clovenbradshaw-ctrl/meshcore-phone/stl/cap/a15_cap.stl

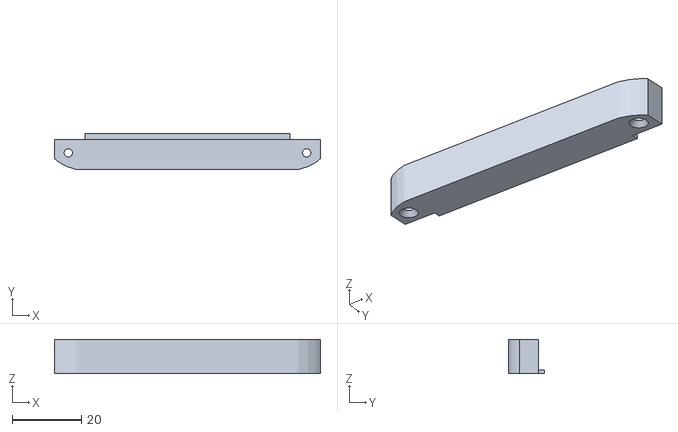
[picture p1: CAD file, 2026-10-25]
stl/cap/a15_cap.stl
76.9 x 10.4 x 9.90
