clovenbradshaw-ctrl/meshcore-phone/stl/no_solar/pixel10a_phone_body.stl

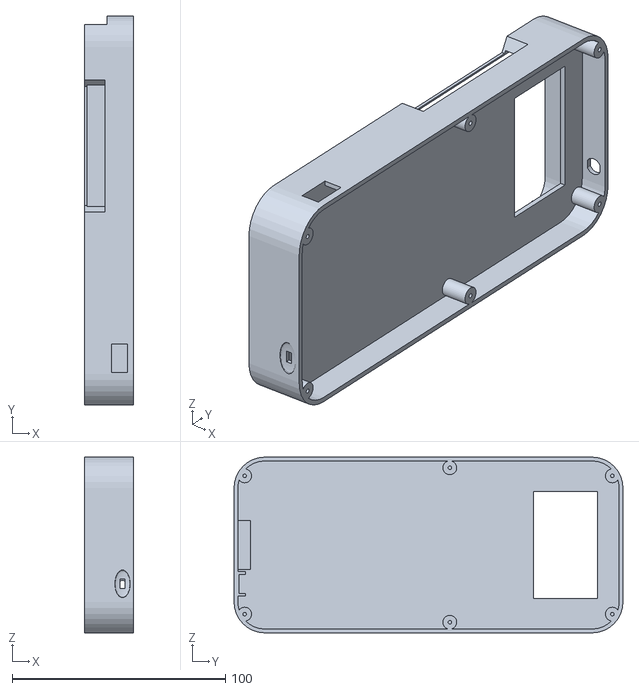
[picture p2: CAD file, 2026-10-26]
stl/no_solar/pixel10a_phone_body.stl
23.2 x 182.6 x 82.5
