clovenbradshaw-ctrl/meshcore-phone/stl/solar/pixel10a_solar_fit_test.stl

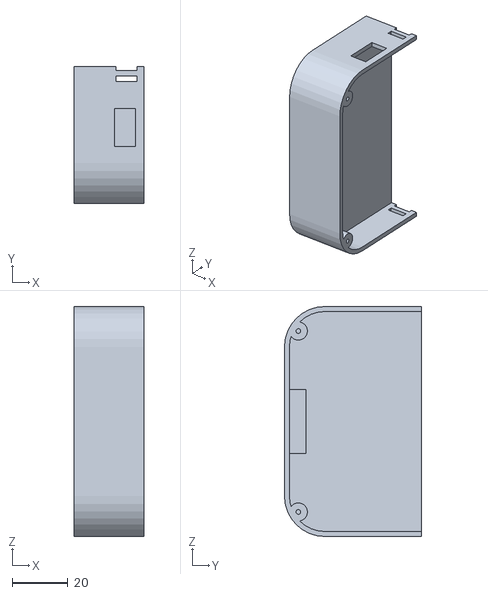
[picture p3: CAD file, 2026-10-26]
stl/solar/pixel10a_solar_fit_test.stl
25.2 x 49.2 x 82.5
