clovenbradshaw-ctrl/meshcore-phone/stl/cap/pixel8a_cap.stl

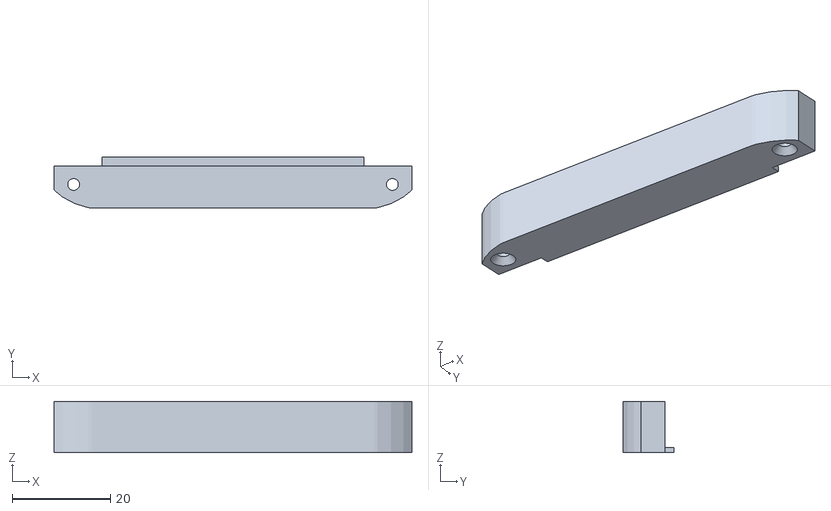
[picture p4: CAD file, 2026-10-25]
stl/cap/pixel8a_cap.stl
72.8 x 10.4 x 10.4
