clovenbradshaw-ctrl/meshcore-phone/stl/solar/pixel9a_solar_body.stl

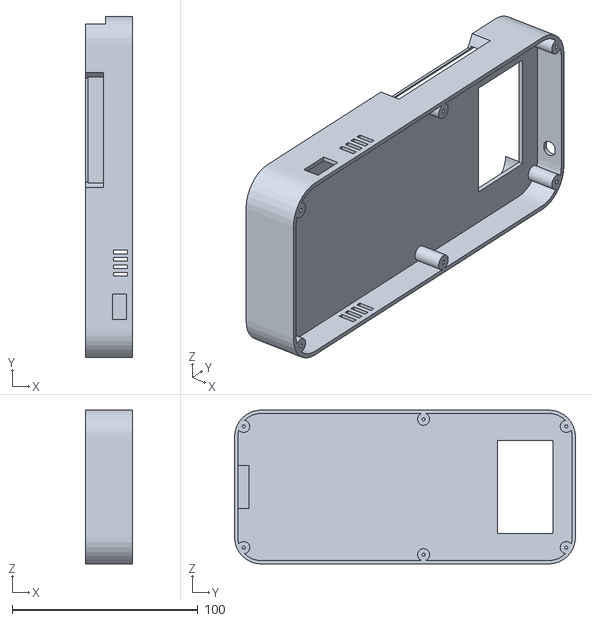
[picture p6: CAD file, 2026-10-26]
stl/solar/pixel9a_solar_body.stl
25.1 x 183.4 x 82.8
