clovenbradshaw-ctrl/meshcore-phone/stl/cap/pixel9_cap.stl

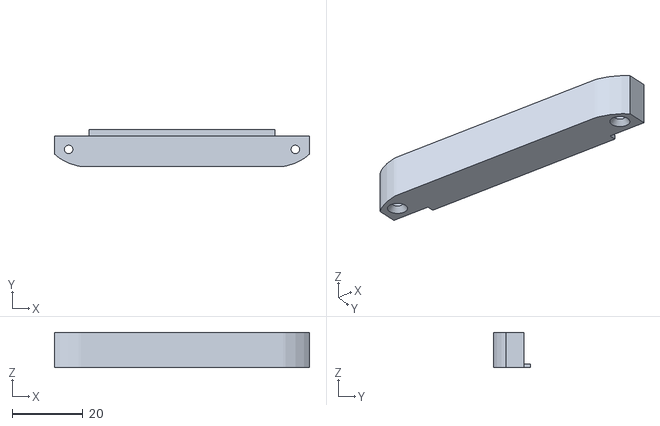
[picture p7: CAD file, 2026-10-25]
stl/cap/pixel9_cap.stl
72.1 x 10.4 x 10.00
