clovenbradshaw-ctrl/meshcore-phone/stl/no_solar/a15_phone_fit_test.stl

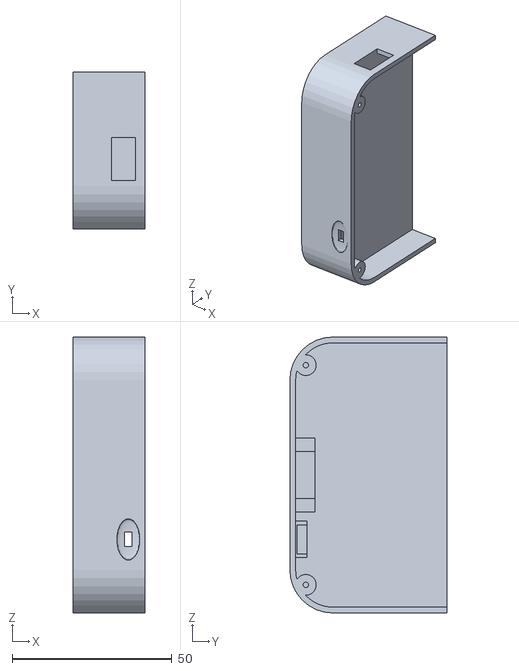
[picture p8: CAD file, 2026-10-26]
stl/no_solar/a15_phone_fit_test.stl
22.6 x 49.2 x 86.3
