clovenbradshaw-ctrl/meshcore-phone/stl/solar/gplay26_solar_fit_test.stl

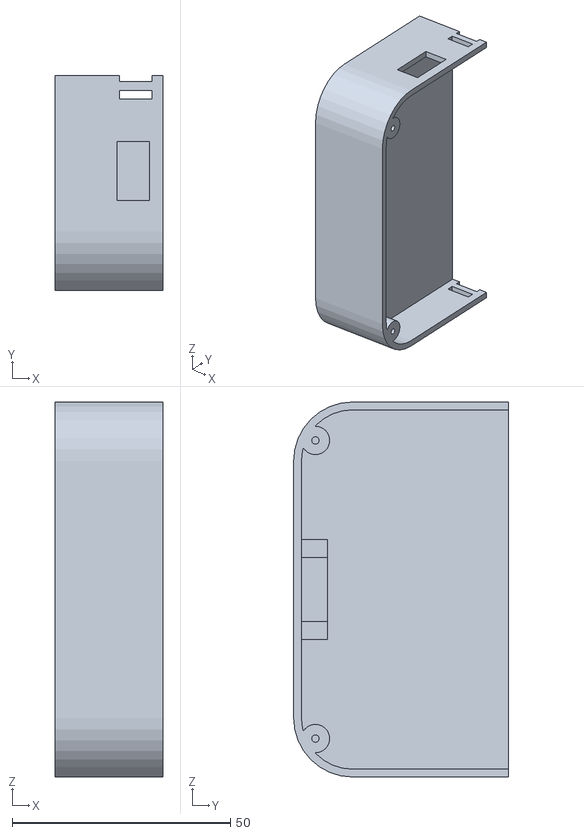
[picture p9: CAD file, 2026-10-26]
stl/solar/gplay26_solar_fit_test.stl
24.7 x 49.2 x 85.9
