clovenbradshaw-ctrl/meshcore-phone/stl/no_solar/pixel9a_phone_fit_test.stl

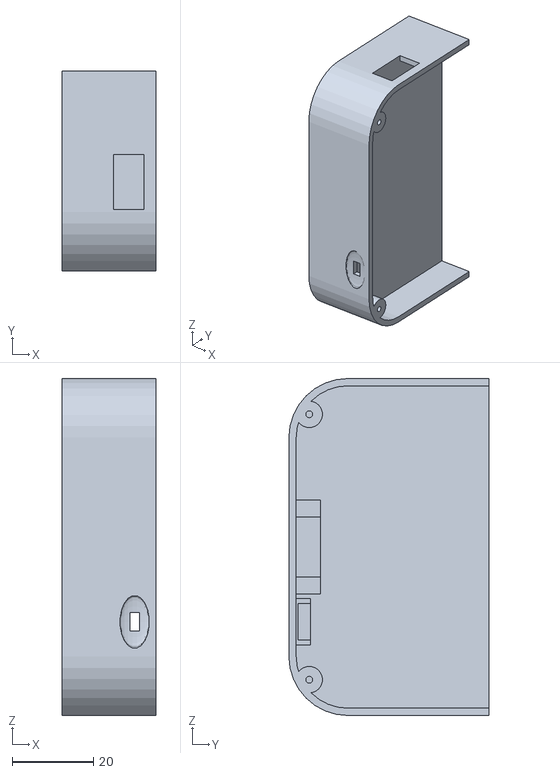
[picture p10: CAD file, 2026-10-26]
stl/no_solar/pixel9a_phone_fit_test.stl
23.1 x 49.2 x 82.8
