clovenbradshaw-ctrl/meshcore-phone/stl/solar/pixel10a_solar_body.stl

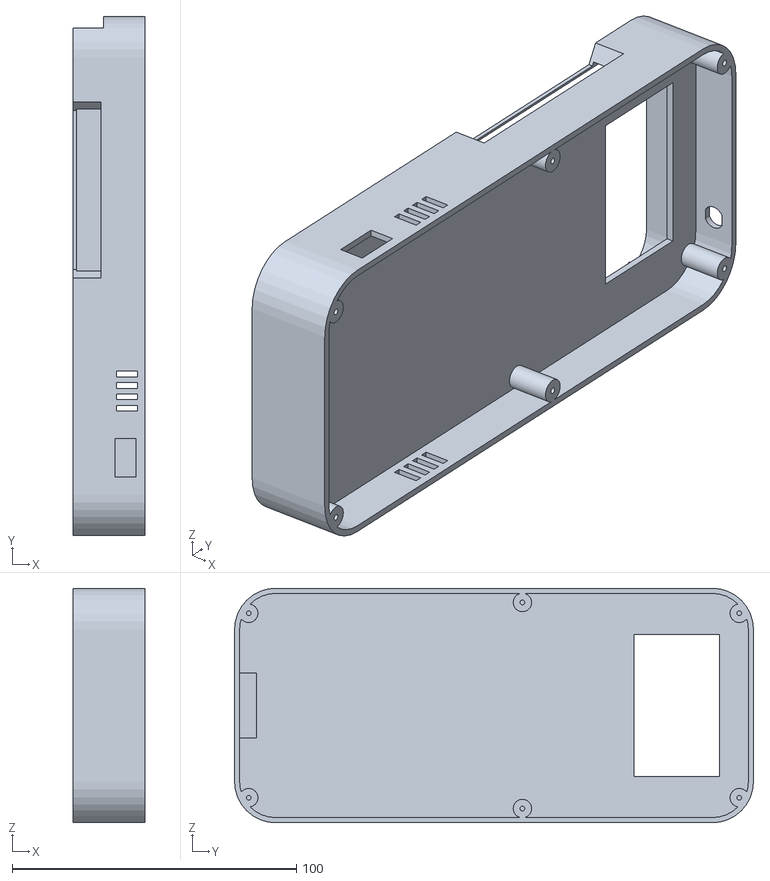
[picture p11: CAD file, 2026-10-26]
stl/solar/pixel10a_solar_body.stl
25.2 x 182.6 x 82.5
