clovenbradshaw-ctrl/meshcore-phone/stl/cap/g25_cap.stl

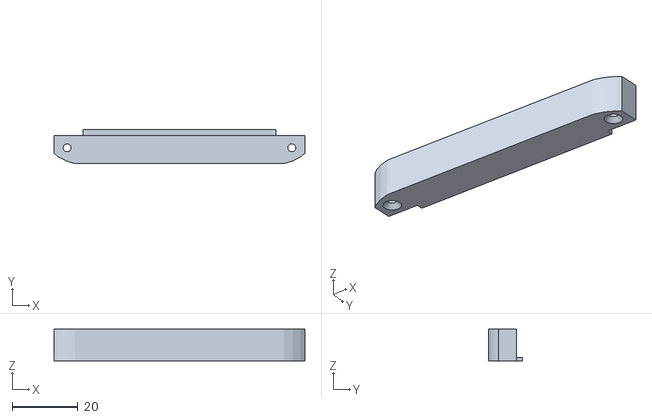
[picture p12: CAD file, 2026-10-25]
stl/cap/g25_cap.stl
76.4 x 10.4 x 9.70
