clovenbradshaw-ctrl/meshcore-phone/stl/no_solar/gplay26_phone_body.stl

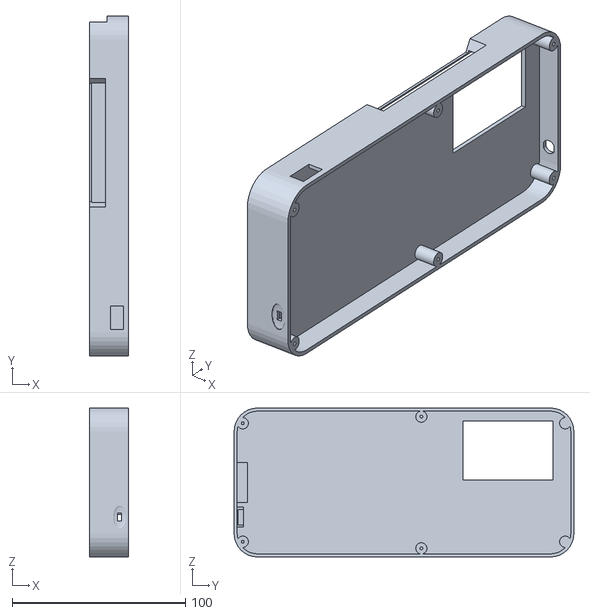
[picture p13: CAD file, 2026-10-26]
stl/no_solar/gplay26_phone_body.stl
22.7 x 195.9 x 85.9
