clovenbradshaw-ctrl/meshcore-phone/stl/solar/a16_solar_body.stl

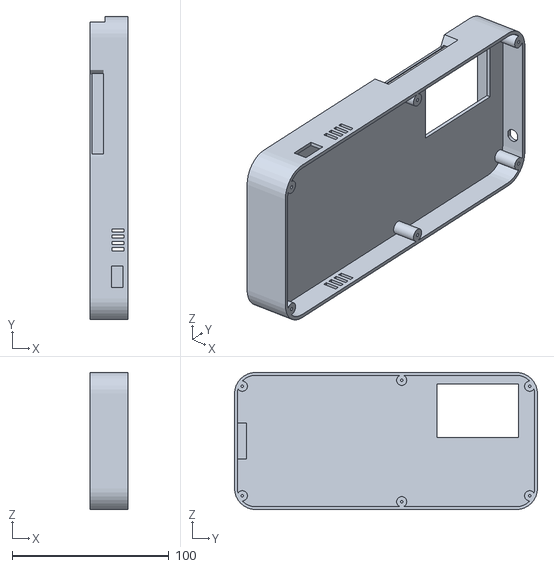
[picture p14: CAD file, 2026-10-26]
stl/solar/a16_solar_body.stl
24.1 x 193.1 x 87.4
