clovenbradshaw-ctrl/meshcore-phone/stl/no_solar/g25_phone_body.stl

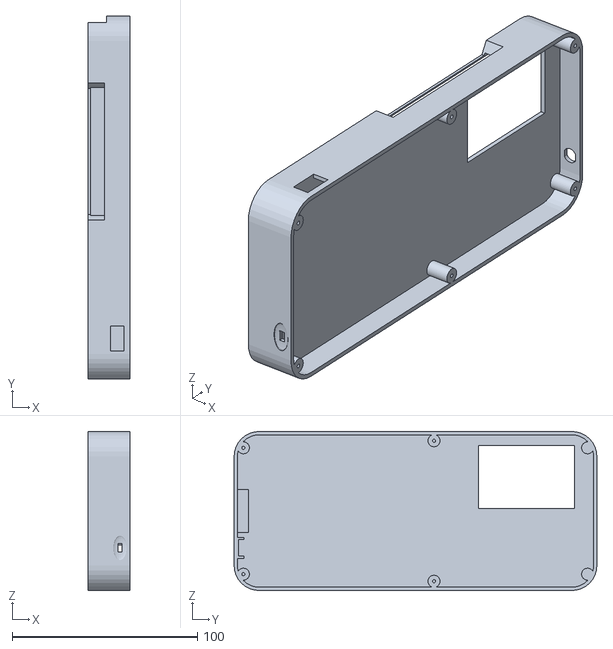
[picture p15: CAD file, 2026-10-26]
stl/no_solar/g25_phone_body.stl
22.4 x 195.8 x 85.8
