clovenbradshaw-ctrl/meshcore-phone/stl/cap/a16_cap.stl

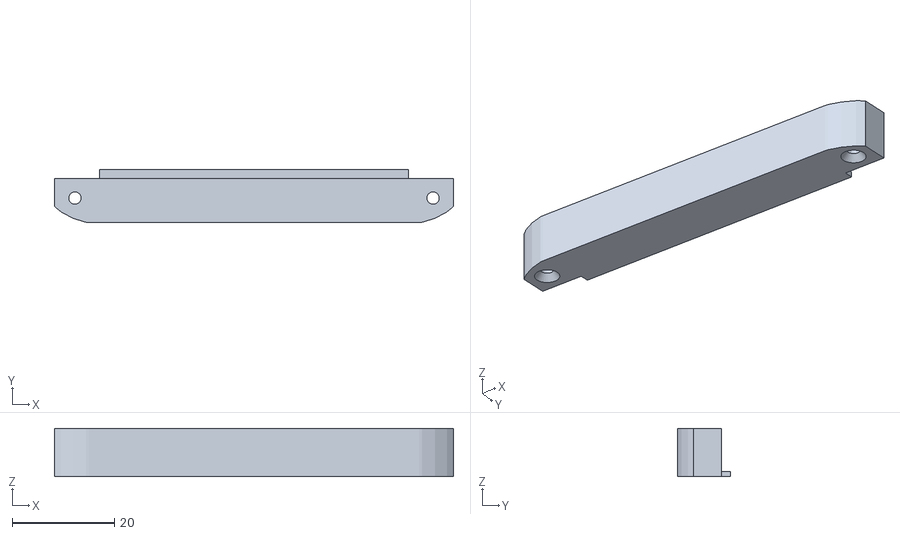
[picture p16: CAD file, 2026-10-25]
stl/cap/a16_cap.stl
78.0 x 10.4 x 9.40
