clovenbradshaw-ctrl/meshcore-phone/stl/solar/pixel9_solar_body.stl

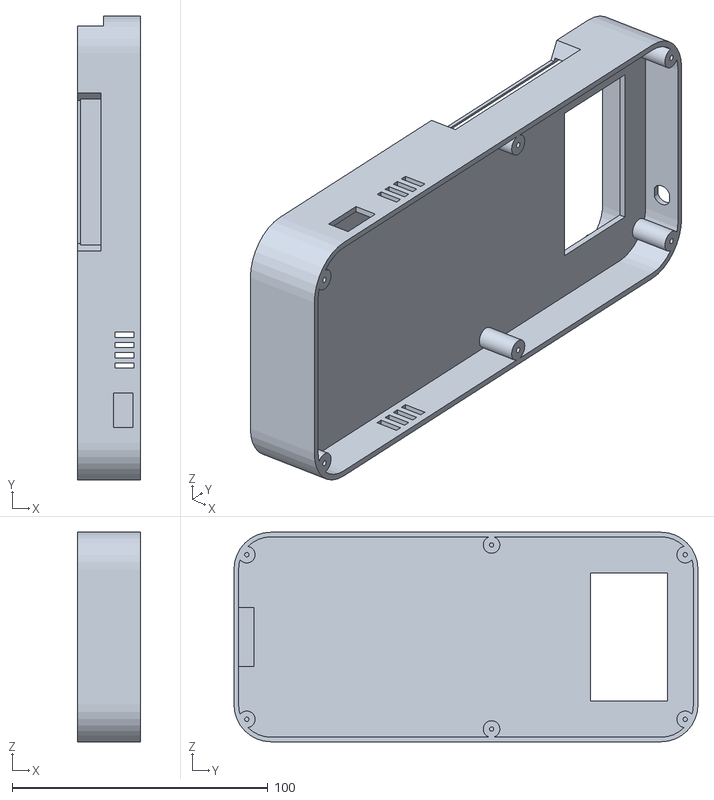
[picture p17: CAD file, 2026-10-26]
stl/solar/pixel9_solar_body.stl
24.7 x 181.5 x 82.0
