clovenbradshaw-ctrl/meshcore-phone/stl/no_solar/a16_phone_fit_test.stl

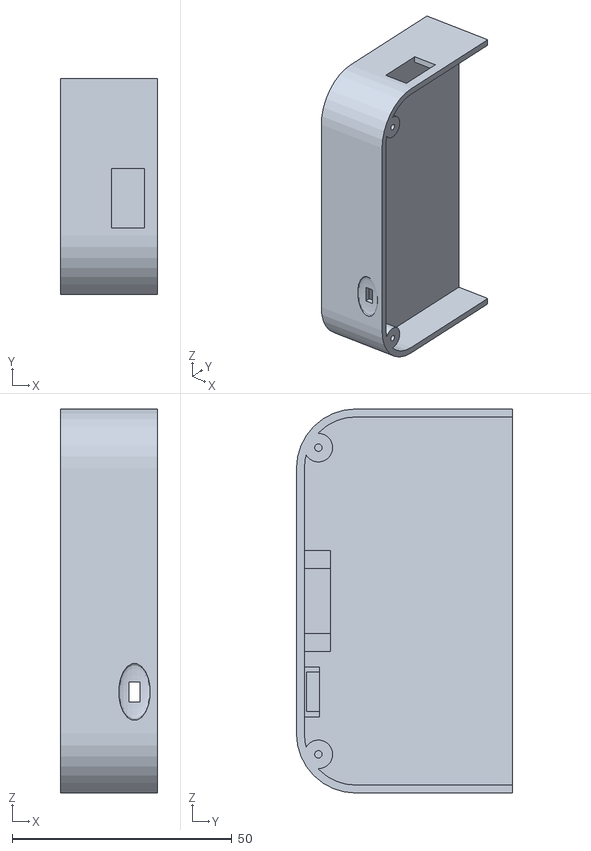
[picture p18: CAD file, 2026-10-26]
stl/no_solar/a16_phone_fit_test.stl
22.1 x 49.2 x 87.4
