clovenbradshaw-ctrl/meshcore-phone/stl/cap/gplay26_cap.stl

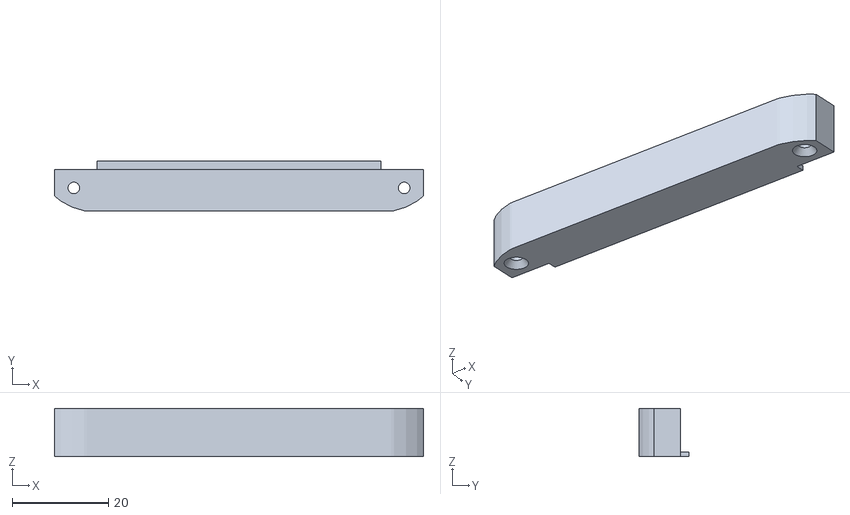
[picture p19: CAD file, 2026-10-25]
stl/cap/gplay26_cap.stl
76.5 x 10.4 x 10.00
