clovenbradshaw-ctrl/meshcore-phone/stl/no_solar/pixel9_phone_fit_test.stl

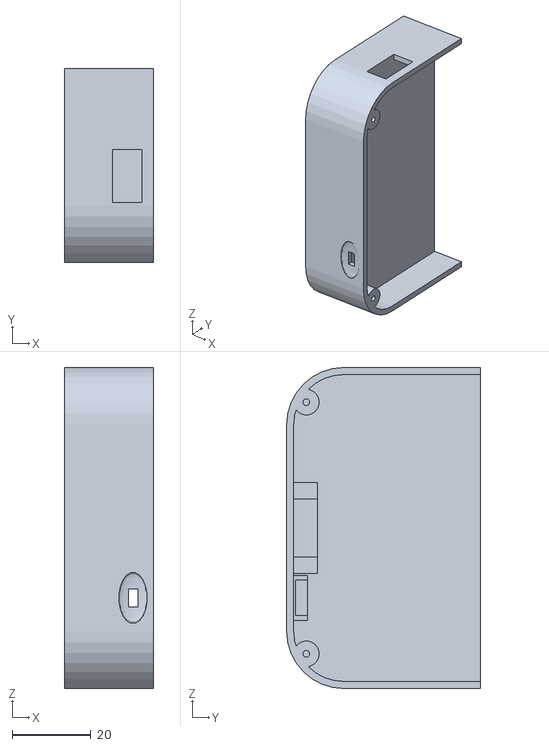
[picture p20: CAD file, 2026-10-26]
stl/no_solar/pixel9_phone_fit_test.stl
22.7 x 49.2 x 81.5
