clovenbradshaw-ctrl/meshcore-phone/stl/no_solar/pixel8a_phone_body.stl

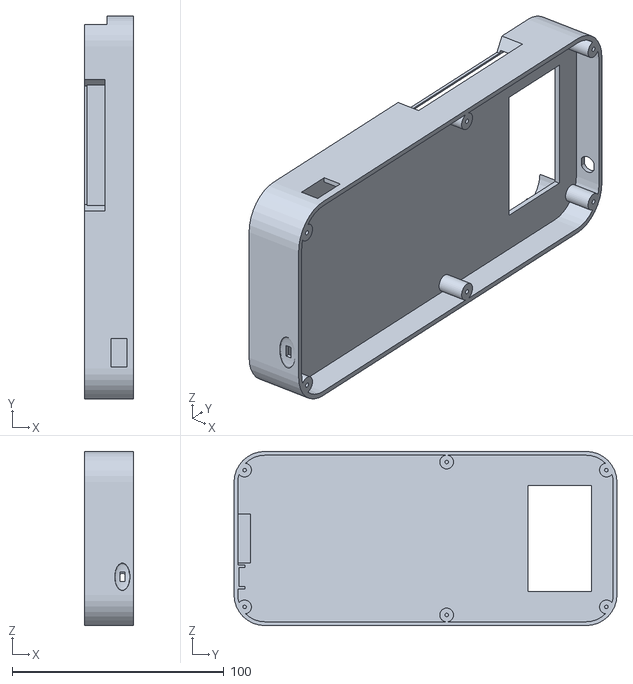
[picture p21: CAD file, 2026-10-26]
stl/no_solar/pixel8a_phone_body.stl
23.1 x 180.8 x 82.2
