clovenbradshaw-ctrl/meshcore-phone/stl/solar/g25_solar_fit_test.stl

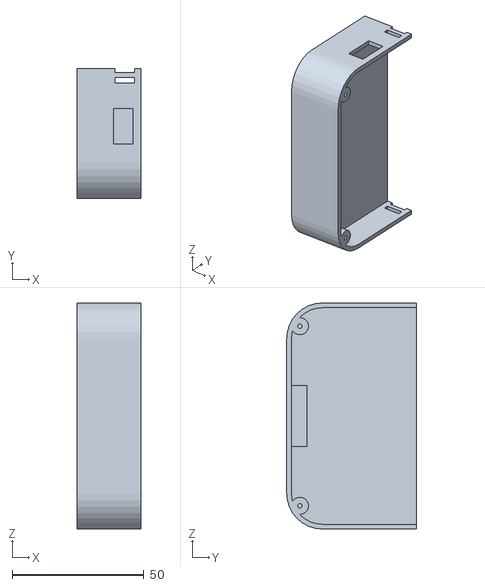
[picture p22: CAD file, 2026-10-26]
stl/solar/g25_solar_fit_test.stl
24.4 x 49.2 x 85.8
