clovenbradshaw-ctrl/meshcore-phone/stl/no_solar/a15_phone_body.stl

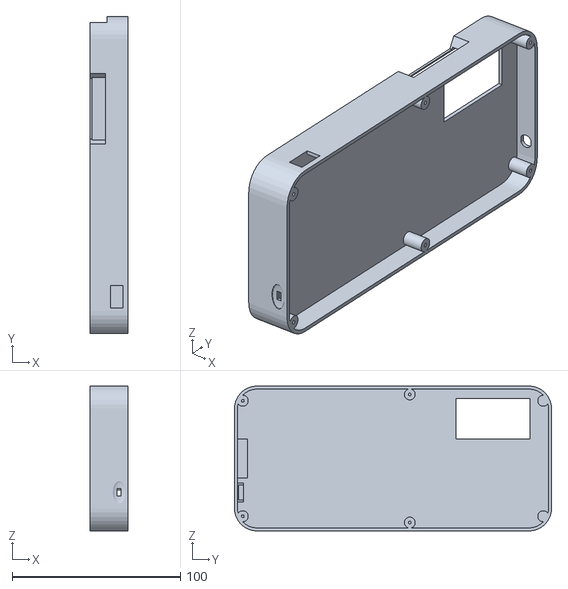
[picture p23: CAD file, 2026-10-26]
stl/no_solar/a15_phone_body.stl
22.6 x 188.8 x 86.3
