clovenbradshaw-ctrl/meshcore-phone/stl/solar/a16_solar_fit_test.stl

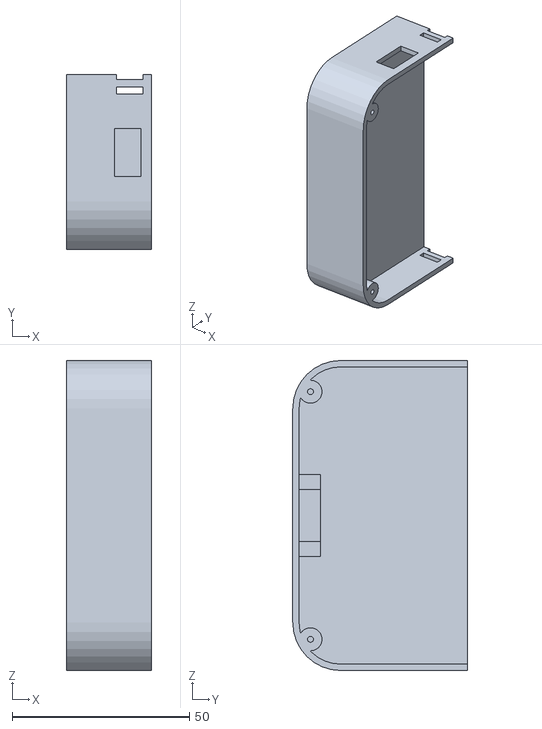
[picture p24: CAD file, 2026-10-26]
stl/solar/a16_solar_fit_test.stl
24.1 x 49.2 x 87.4
