clovenbradshaw-ctrl/meshcore-phone/stl/no_solar/pixel9a_phone_body.stl

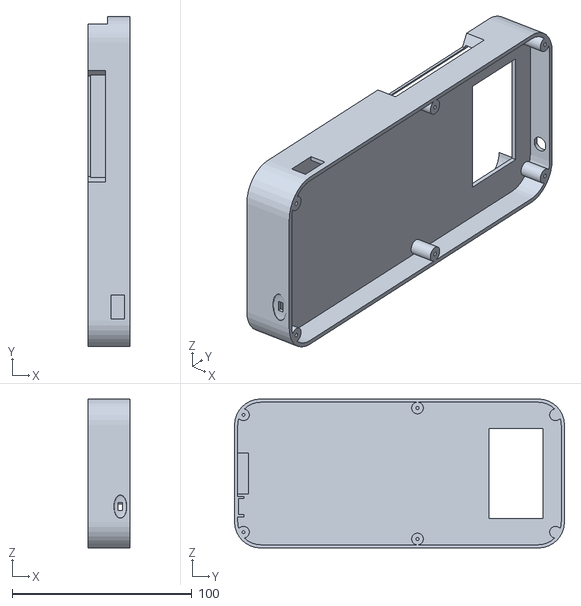
[picture p25: CAD file, 2026-10-26]
stl/no_solar/pixel9a_phone_body.stl
23.1 x 183.4 x 82.8
