clovenbradshaw-ctrl/meshcore-phone/stl/solar/pixel9a_solar_fit_test.stl

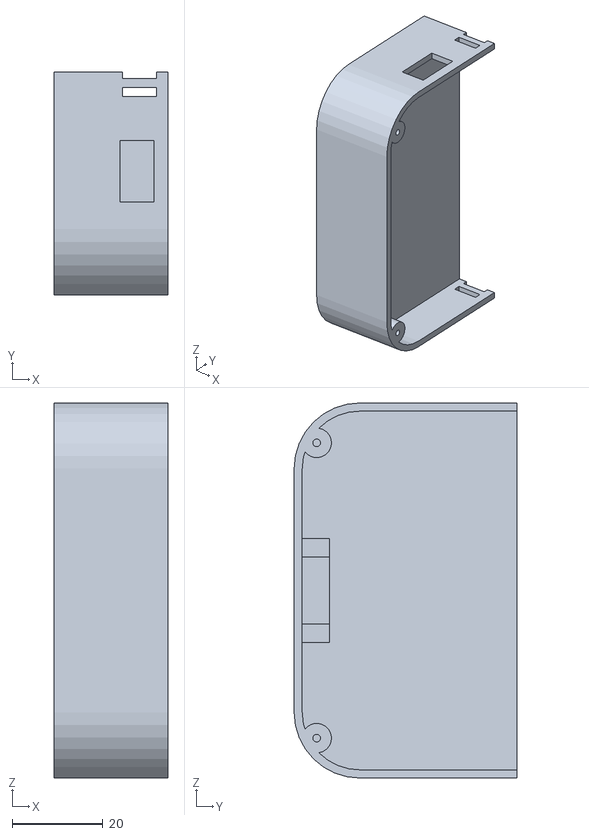
[picture p26: CAD file, 2026-10-26]
stl/solar/pixel9a_solar_fit_test.stl
25.1 x 49.2 x 82.8
