clovenbradshaw-ctrl/meshcore-phone/stl/no_solar/g25_phone_fit_test.stl

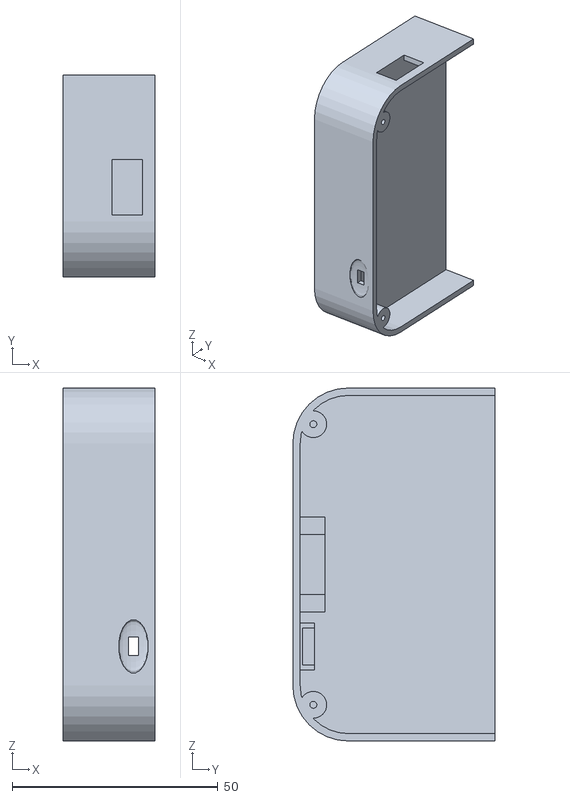
[picture p27: CAD file, 2026-10-26]
stl/no_solar/g25_phone_fit_test.stl
22.4 x 49.2 x 85.8
