clovenbradshaw-ctrl/meshcore-phone/stl/solar/g25_solar_body.stl

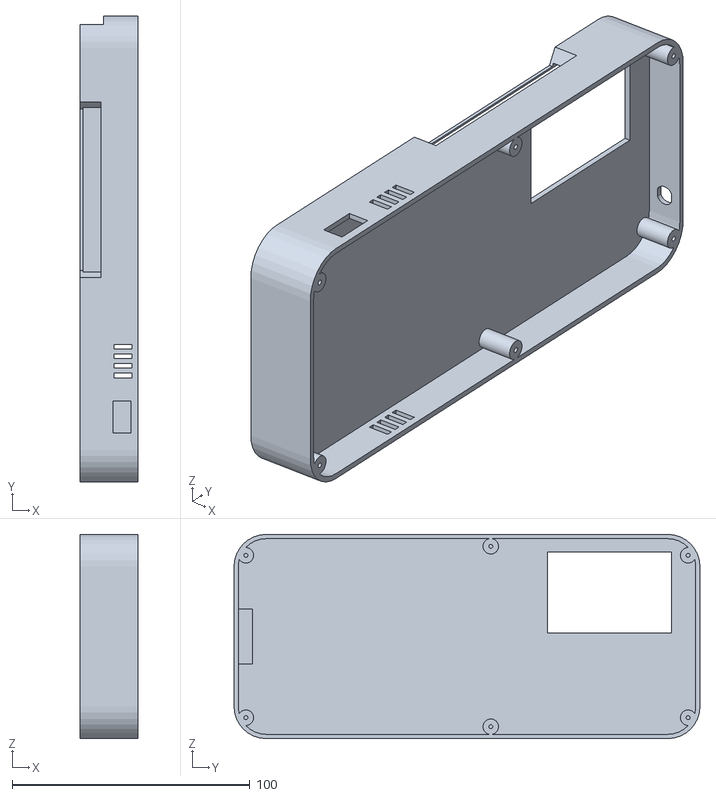
[picture p28: CAD file, 2026-10-26]
stl/solar/g25_solar_body.stl
24.4 x 195.8 x 85.8
