clovenbradshaw-ctrl/meshcore-phone/stl/no_solar/a16_phone_body.stl

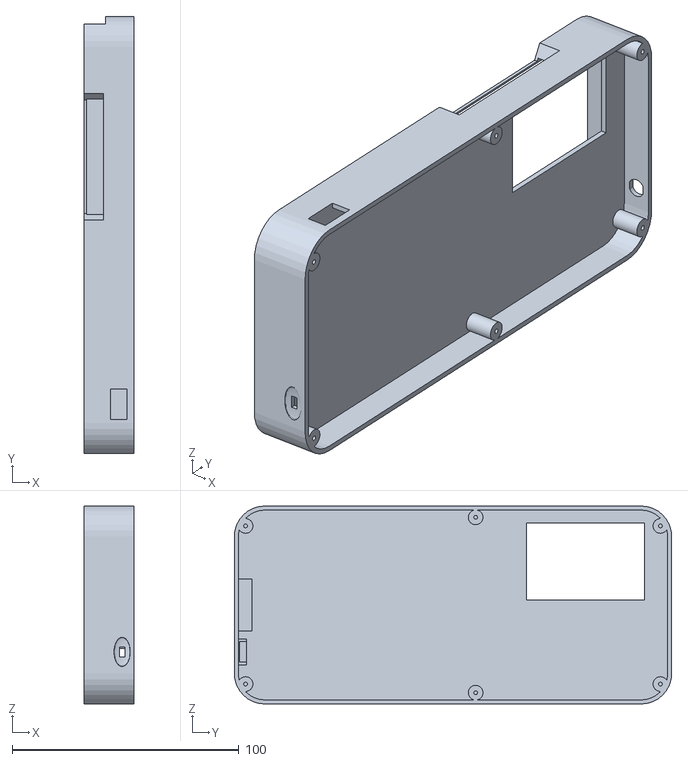
[picture p29: CAD file, 2026-10-26]
stl/no_solar/a16_phone_body.stl
22.1 x 193.1 x 87.4
