clovenbradshaw-ctrl/meshcore-phone/stl/solar/a15_solar_body.stl

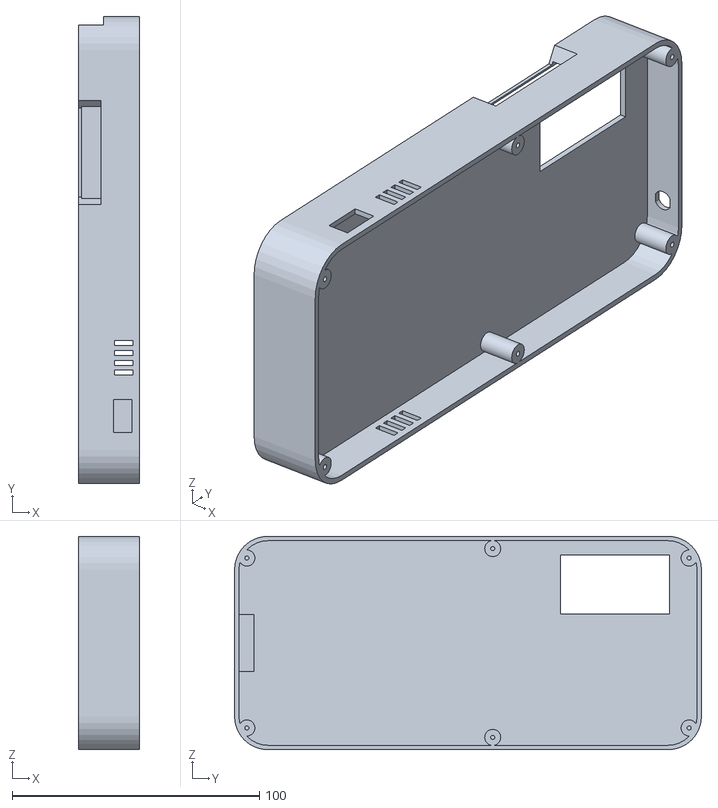
[picture p30: CAD file, 2026-10-26]
stl/solar/a15_solar_body.stl
24.6 x 188.8 x 86.3
