clovenbradshaw-ctrl/meshcore-phone/stl/solar/gplay26_solar_body.stl

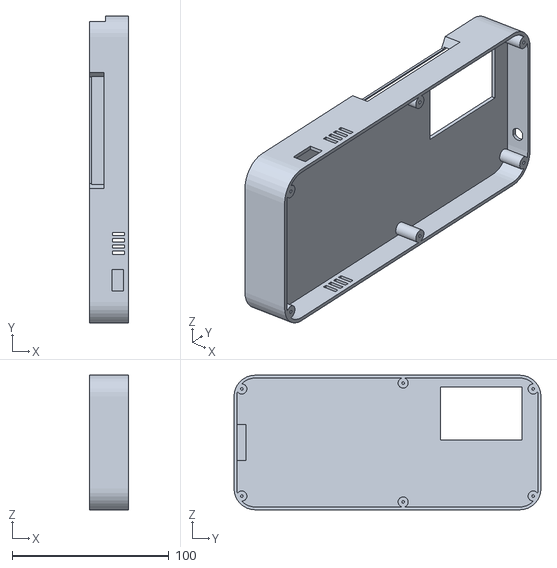
[picture p31: CAD file, 2026-10-26]
stl/solar/gplay26_solar_body.stl
24.7 x 195.9 x 85.9
