clovenbradshaw-ctrl/meshcore-phone/stl/no_solar/g25_phone_side_test.stl

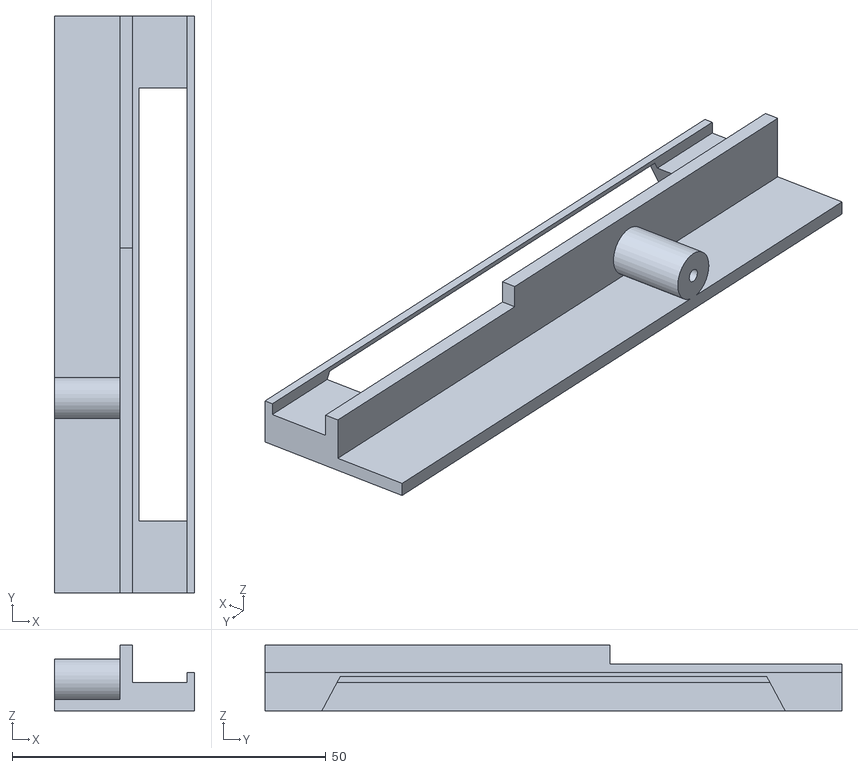
[picture p32: CAD file, 2026-10-25]
stl/no_solar/g25_phone_side_test.stl
22.4 x 92.0 x 10.5
