clovenbradshaw-ctrl/meshcore-phone/stl/solar/a16_solar_lid.stl

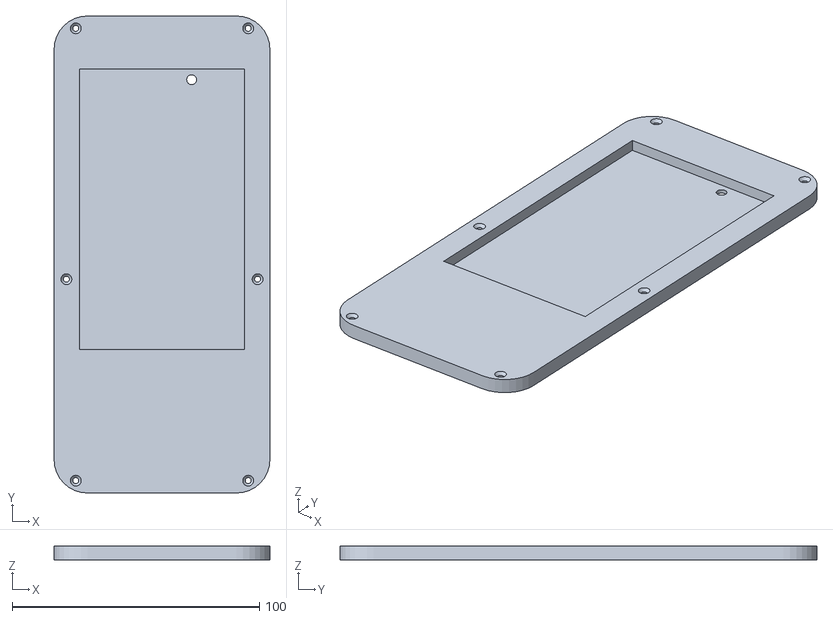
[picture p33: CAD file, 2026-10-25]
stl/solar/a16_solar_lid.stl
87.4 x 193.1 x 5.60
