clovenbradshaw-ctrl/meshcore-phone/stl/no_solar/a15_phone_lid.stl

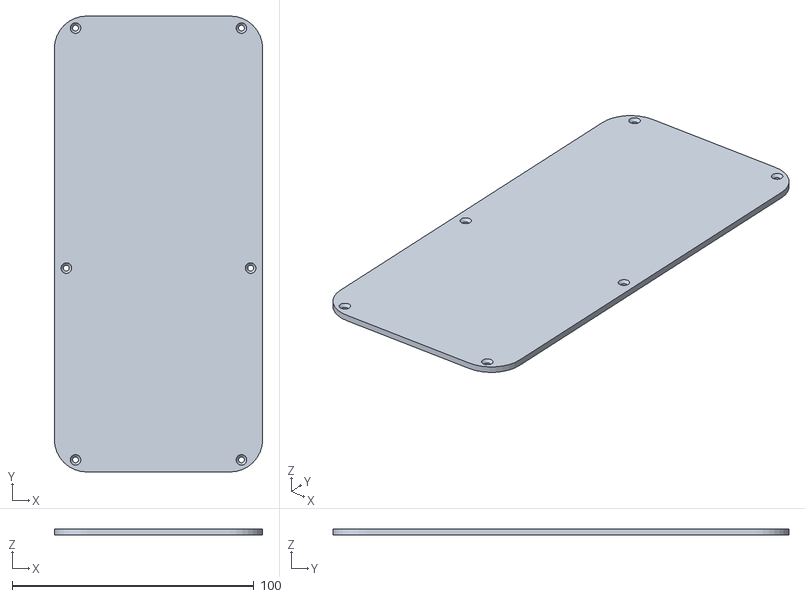
[picture p34: CAD file, 2026-10-25]
stl/no_solar/a15_phone_lid.stl
86.3 x 188.8 x 2.40
