clovenbradshaw-ctrl/meshcore-phone/stl/solar/pixel10a_solar_side_test.stl

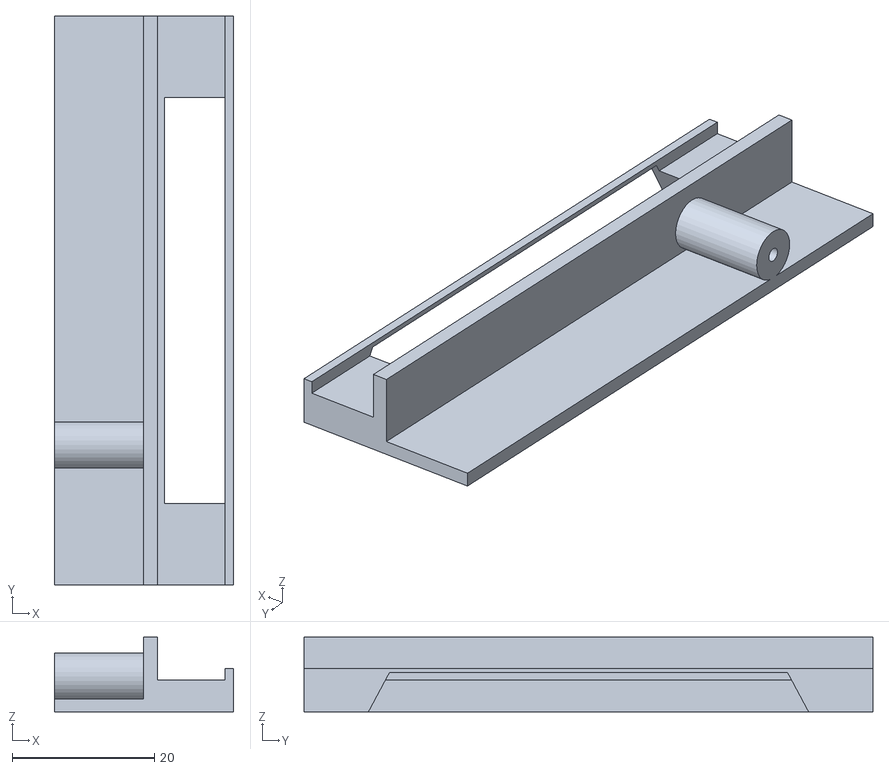
[picture p35: CAD file, 2026-10-25]
stl/solar/pixel10a_solar_side_test.stl
25.2 x 80.0 x 10.5
