clovenbradshaw-ctrl/meshcore-phone/stl/no_solar/pixel10_phone_lid.stl

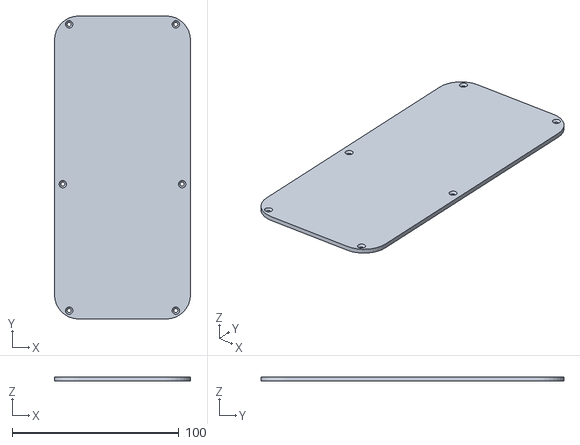
[picture p36: CAD file, 2026-10-25]
stl/no_solar/pixel10_phone_lid.stl
81.5 x 181.5 x 2.40
