clovenbradshaw-ctrl/meshcore-phone/stl/solar/gplay26_solar_lid.stl

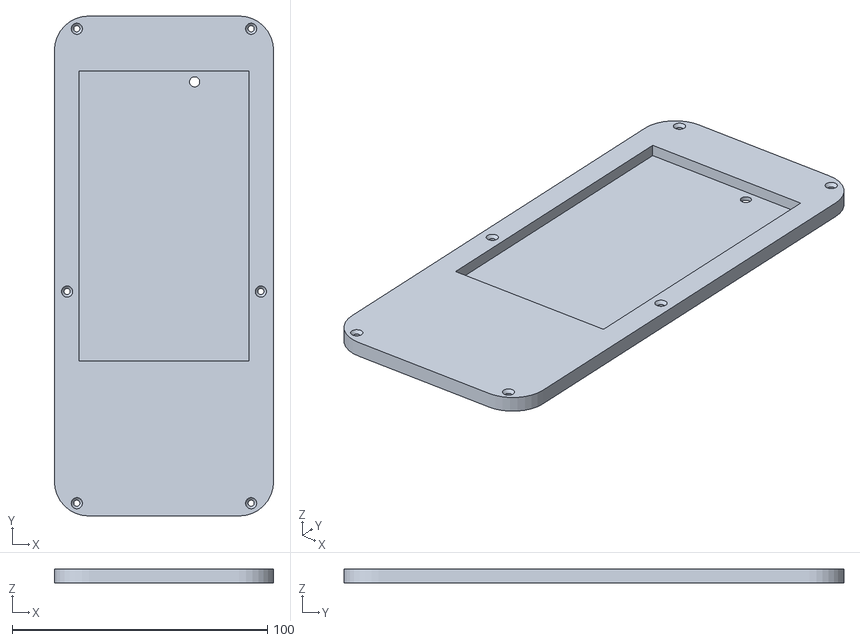
[picture p37: CAD file, 2026-10-25]
stl/solar/gplay26_solar_lid.stl
85.9 x 195.9 x 5.60
