clovenbradshaw-ctrl/meshcore-phone/stl/no_solar/a16_phone_lid.stl

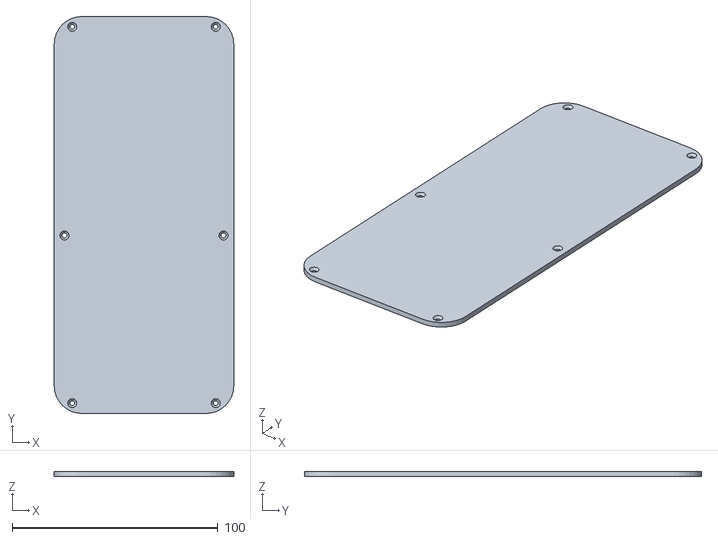
[picture p38: CAD file, 2026-10-25]
stl/no_solar/a16_phone_lid.stl
87.4 x 193.1 x 2.40
