clovenbradshaw-ctrl/meshcore-phone/stl/solar/pixel10_solar_lid.stl

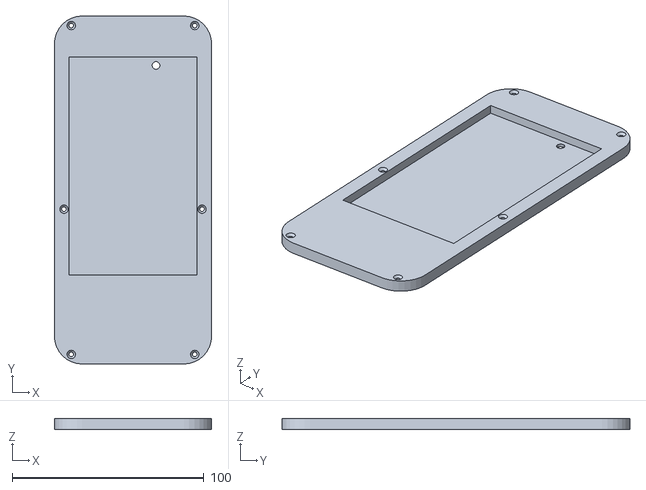
[picture p39: CAD file, 2026-10-25]
stl/solar/pixel10_solar_lid.stl
82.0 x 181.5 x 5.60
