clovenbradshaw-ctrl/meshcore-phone/stl/no_solar/pixel9_phone_side_test.stl

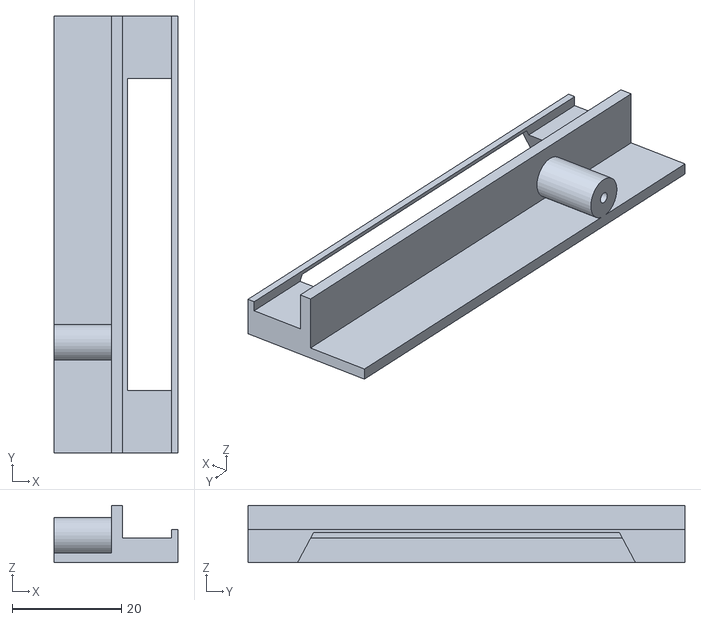
[picture p40: CAD file, 2026-10-25]
stl/no_solar/pixel9_phone_side_test.stl
22.7 x 80.0 x 10.5
