clovenbradshaw-ctrl/meshcore-phone/stl/no_solar/gplay26_phone_lid.stl

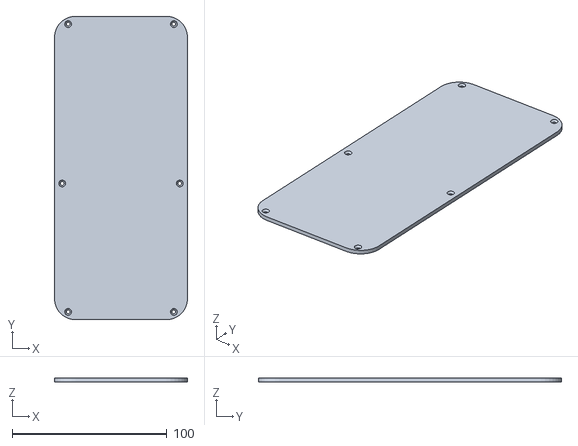
[picture p41: CAD file, 2026-10-25]
stl/no_solar/gplay26_phone_lid.stl
85.9 x 195.9 x 2.40
