clovenbradshaw-ctrl/meshcore-phone/stl/solar/a15_solar_lid.stl

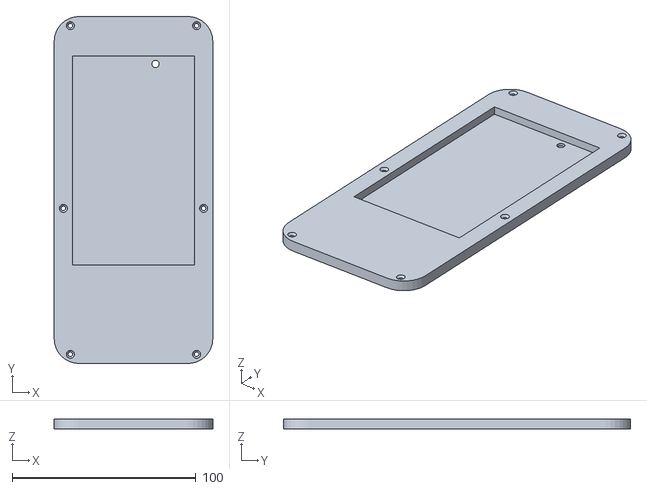
[picture p42: CAD file, 2026-10-25]
stl/solar/a15_solar_lid.stl
86.3 x 188.8 x 5.60
