clovenbradshaw-ctrl/meshcore-phone/stl/solar/gplay26_solar_side_test.stl

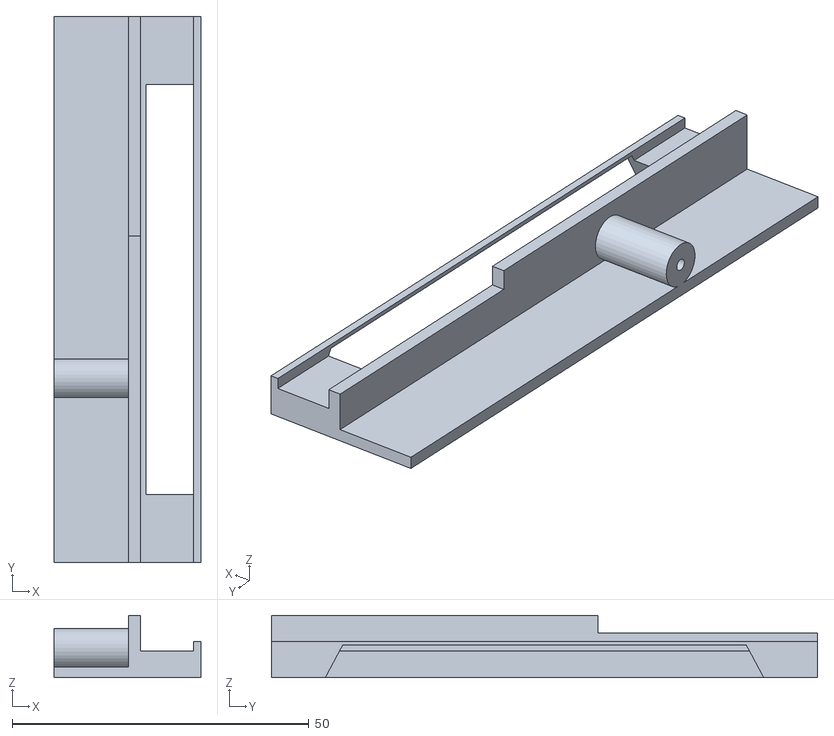
[picture p43: CAD file, 2026-10-25]
stl/solar/gplay26_solar_side_test.stl
24.7 x 92.0 x 10.5
