clovenbradshaw-ctrl/meshcore-phone/stl/no_solar/gplay26_phone_side_test.stl

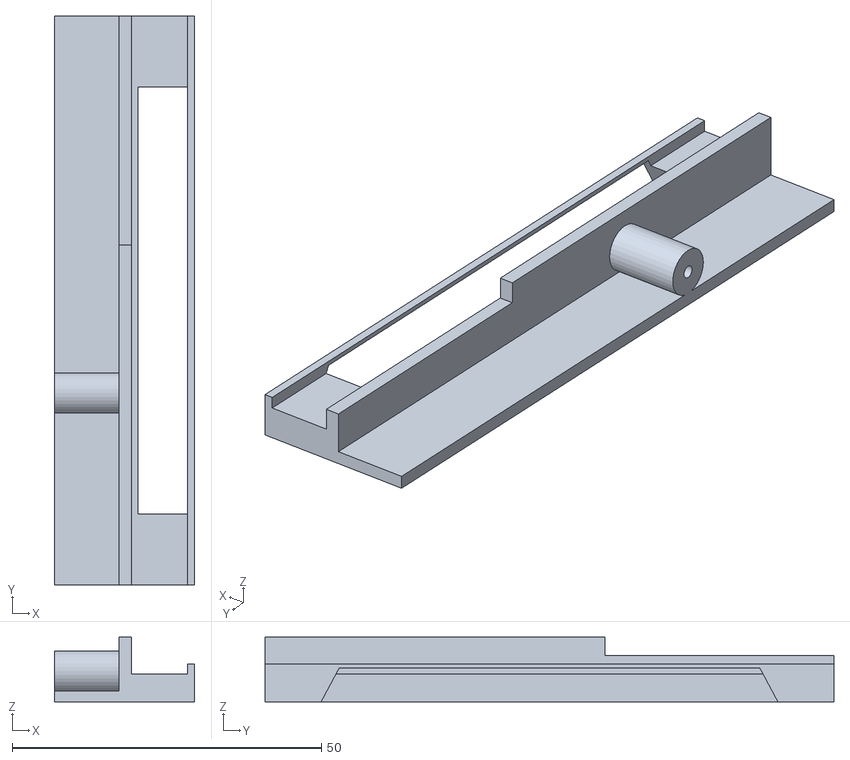
[picture p44: CAD file, 2026-10-25]
stl/no_solar/gplay26_phone_side_test.stl
22.7 x 92.0 x 10.5
