clovenbradshaw-ctrl/meshcore-phone/stl/solar/a16_solar_side_test.stl

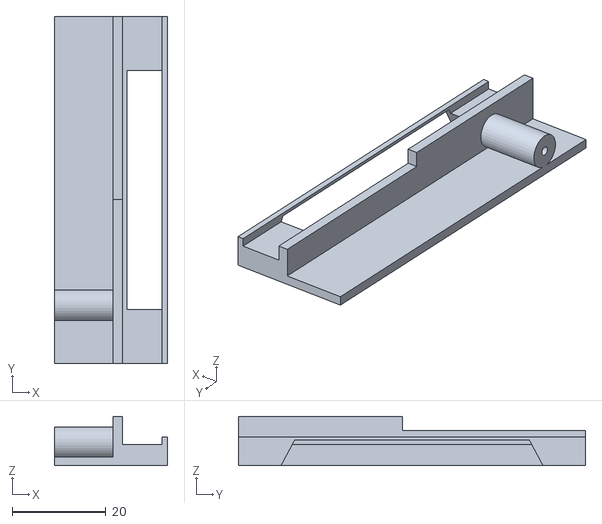
[picture p45: CAD file, 2026-10-25]
stl/solar/a16_solar_side_test.stl
24.1 x 74.0 x 10.5
