clovenbradshaw-ctrl/meshcore-phone/stl/no_solar/a16_phone_side_test.stl

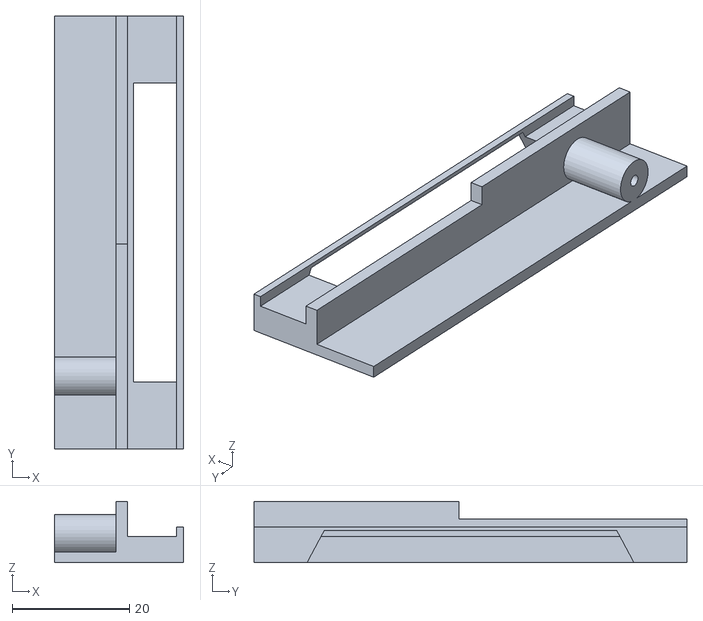
[picture p46: CAD file, 2026-10-25]
stl/no_solar/a16_phone_side_test.stl
22.1 x 74.0 x 10.5
