clovenbradshaw-ctrl/meshcore-phone/stl/no_solar/a15_phone_side_test.stl

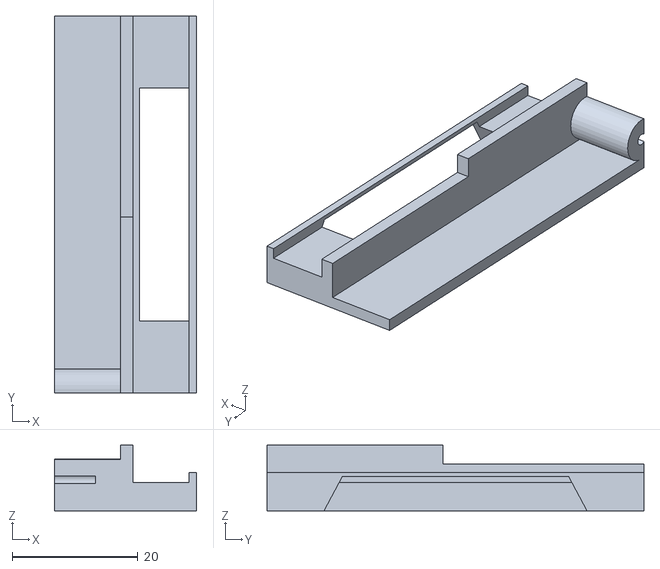
[picture p47: CAD file, 2026-10-25]
stl/no_solar/a15_phone_side_test.stl
22.6 x 60.0 x 10.5
