clovenbradshaw-ctrl/meshcore-phone/stl/no_solar/pixel10a_phone_lid.stl

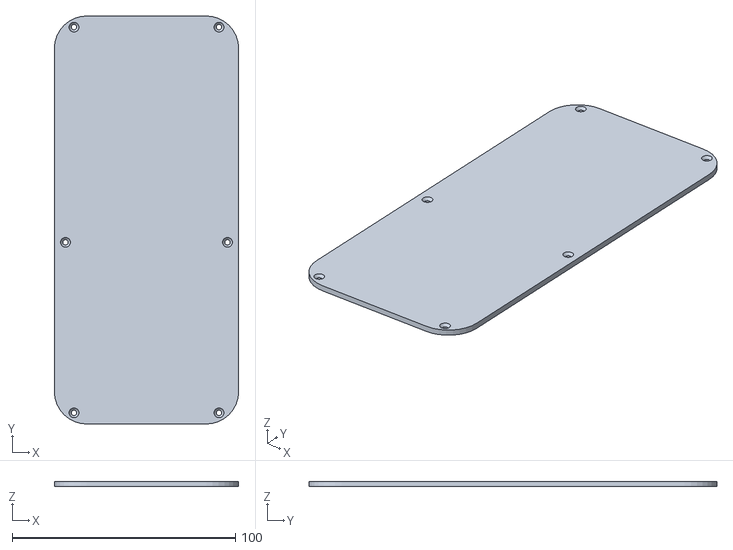
[picture p48: CAD file, 2026-10-25]
stl/no_solar/pixel10a_phone_lid.stl
82.5 x 182.6 x 2.40
