clovenbradshaw-ctrl/meshcore-phone/stl/solar/pixel9_solar_side_test.stl

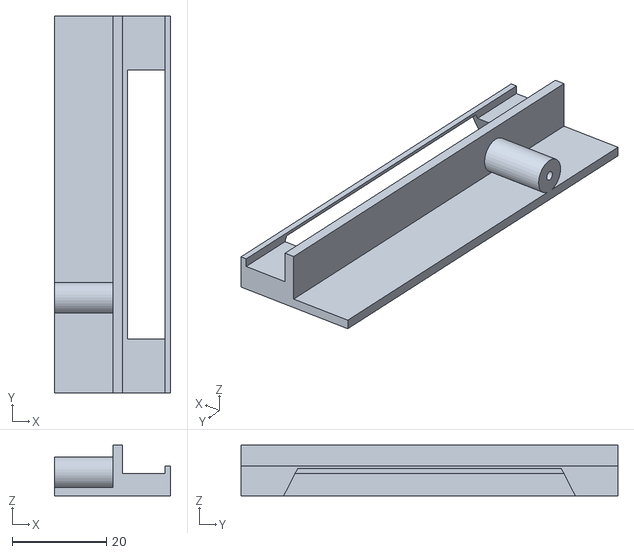
[picture p49: CAD file, 2026-10-25]
stl/solar/pixel9_solar_side_test.stl
24.7 x 80.0 x 10.8
