clovenbradshaw-ctrl/meshcore-phone/stl/solar/a15_solar_side_test.stl

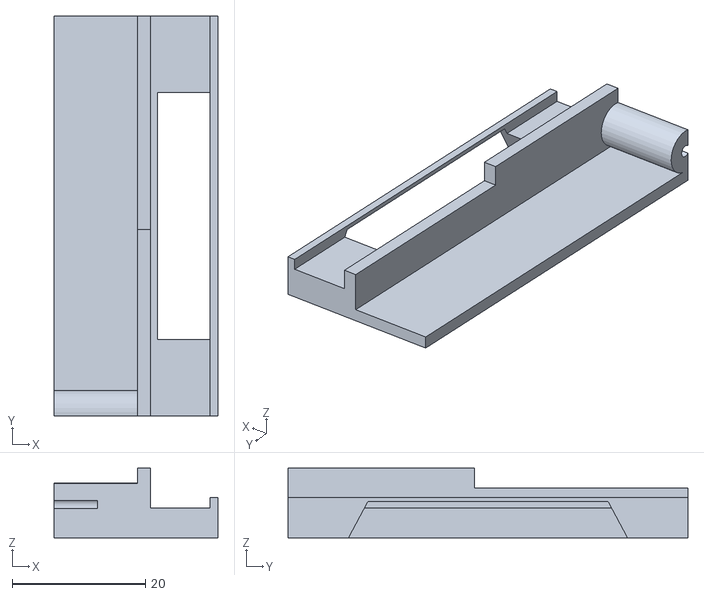
[picture p50: CAD file, 2026-10-25]
stl/solar/a15_solar_side_test.stl
24.6 x 60.0 x 10.5
