clovenbradshaw-ctrl/meshcore-phone/stl/no_solar/pixel9a_phone_lid.stl

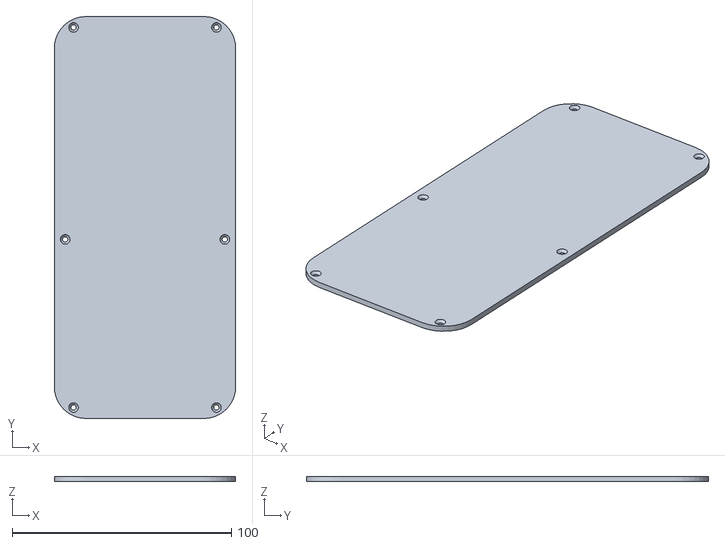
[picture p51: CAD file, 2026-10-25]
stl/no_solar/pixel9a_phone_lid.stl
82.8 x 183.4 x 2.40
