clovenbradshaw-ctrl/meshcore-phone/stl/solar/g25_solar_side_test.stl

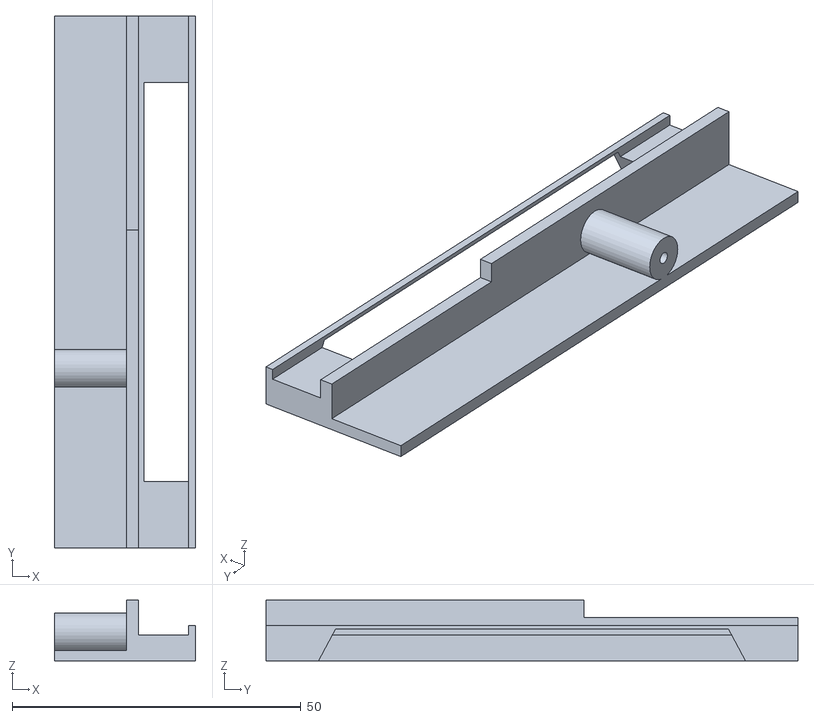
[picture p52: CAD file, 2026-10-25]
stl/solar/g25_solar_side_test.stl
24.4 x 92.0 x 10.5
