clovenbradshaw-ctrl/meshcore-phone/stl/solar/pixel9a_solar_lid.stl

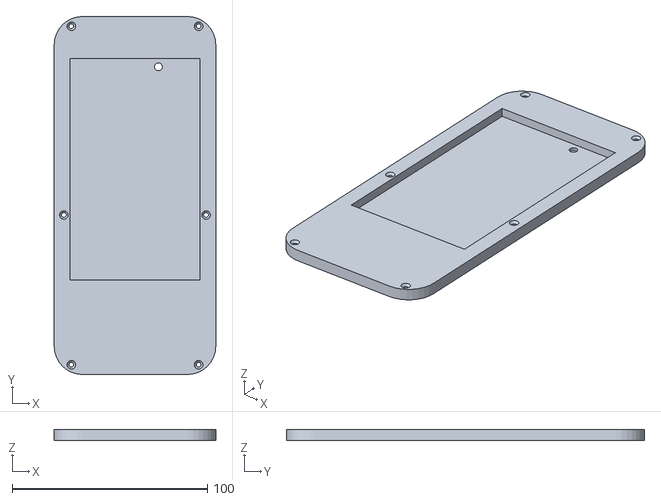
[picture p53: CAD file, 2026-10-25]
stl/solar/pixel9a_solar_lid.stl
82.8 x 183.4 x 5.60
