clovenbradshaw-ctrl/meshcore-phone/(list of files, cad)

Other CAD files:
stl/cap/pixel10_cap.stl
stl/cap/pixel9a_cap.stl
stl/solar/a15_solar_fit_test.stl
stl/no_solar/gplay26_phone_fit_test.stl
stl/cap/pixel10a_cap.stl
stl/solar/pixel9_solar_fit_test.stl
stl/solar/pixel10_solar_fit_test.stl
stl/solar/pixel8a_solar_fit_test.stl
stl/no_solar/pixel10_phone_body.stl
stl/no_solar/pixel9_phone_body.stl
stl/no_solar/pixel10_phone_fit_test.stl
stl/solar/pixel10_solar_body.stl
stl/no_solar/pixel10a_phone_fit_test.stl
stl/solar/pixel8a_solar_body.stl
stl/solar/g25_solar_lid.stl
stl/no_solar/pixel10_phone_side_test.stl
stl/no_solar/g25_phone_lid.stl
stl/solar/pixel8a_solar_side_test.stl
stl/solar/pixel9a_solar_side_test.stl
stl/solar/pixel10a_solar_lid.stl
stl/no_solar/pixel10a_phone_side_test.stl
stl/solar/pixel8a_solar_lid.stl
stl/no_solar/pixel9_phone_lid.stl
stl/no_solar/pixel8a_phone_lid.stl
stl/solar/pixel9_solar_lid.stl
stl/no_solar/pixel9a_phone_side_test.stl
stl/no_solar/pixel8a_phone_side_test.stl
stl/solar/pixel10_solar_side_test.stl
