clovenbradshaw-ctrl/meshcore-phone/manual/index.html

# MeshCore phone: build manual

A dedicated LoRa mesh messenger built from a cheap phone, a XIAO radio and three 3D-printed parts. Pick your phone and version, buy the parts with one cart link, then follow the steps.

BackFrontSideIsoLayersBottom end

Explode0%

Phone

Version

Solar + battery6000 mAh + panel No solarphone only

Radio link

Bluetooth, with the official MeshCore app on Android or iPhone. Always connected.

Total for this buildBuilding units

DigiKey cart Download STL files

I already have solder, heat-shrink, wire and epoxy

## How the phone charges

## Or buy one ready-made

Prices are single-unit retail prices seen in October 2026 and change often. None of these sits inside the phone case or uses the screw-on antenna; each is a separate device that pairs with the phone over Bluetooth.

## 1Build it, step by step

Each step sets the 3D view at the top: parts used in that step are in full colour, everything else is faded. Use the explode slider to pull everything apart.

Previous Next step

## 2Buy the parts

Add the parts to one DigiKey cart Download STL files

### Tools and shop supplies

## 3Print the three parts

Light-coloured ASA keeps the case cooler in sun and does not soften until about 100 °C. The STL files for the five ready-made phones are in the download; for any other phone, generate them with the command in section 6.

Print the two test pieces first. The fit test is the bottom 30 mm of the body; the button test is the button-side wall with its window (about 30 minutes): slide your phone against it and check that the power and volume buttons sit inside the window. Check the phone plug board, the switch slot (No solar) and how the phone seats before printing the full body.

## 4Wiring

## 5Using it

### Switches and charging

### Heat and safety

## 6Other phones and checks

Not yet proven on a real build. These are measured guesses until someone builds one: the charger board size and where its USB-C sits, the radio stack height, whether the switch knob slot (4.5 × 2.4 mm) matches your switch's knob, the button and camera positions on every phone except the Galaxy A15, and every temperature in the heat notes. The fit test print checks the side port, switch slots and phone plug before you commit to the full body.

### Generate parts for your phone

Measure the phone with calipers, enter it here and run the command with OpenSCAD and the meshcore_onepiece.scad file from the download.
