clovenbradshaw-ctrl/meshcore-phone/(commit log)

2026-10-25 MeshCore phone case: CAD, print files, build manual, parts list
    Phone-powered MeshCore radio (XIAO nRF52840 + Wio-SX1262) in a 3D-printed
    case with a screw-on SMA antenna, one USE/CHARGE switch, and Solar,
    Solar + battery and No solar versions. Print-ready STLs for nine phones.
    Claude-Session: https://claude.ai/code/session_01TdAgQfoE6w77w98UpXUwhd
    [a15_cap.stl, a15_phone_body.stl, a15_phone_fit_test.stl, a15_phone_lid.stl, a15_phone_side_test.stl, a15_solar_body.stl, a15_solar_fit_test.stl, a15_solar_lid.stl]
2026-10-26 Serve the manual from GitHub Pages: move phone data to a sidecar
    manual/index.html embedded 5.6 MB of base64 STL meshes and the 2,135-row
    phone size list in one inline script (6.1 MB page). Move both into
    manual/phone-data.js (window.MESHCORE) so the page is 137 KB and the data
    loads as a normal cacheable script. Add a root redirect and .nojekyll for
    Pages.
2026-10-26 Manual: one battery for every build, Bluetooth only, solar panel fix
    - Merge Solar (950 mAh) and Solar + battery (6000 mAh) into one Solar +
    battery version. The 6000 mAh cell is used unless the phone is shorter
    than 144.7 mm (27 of 2,140 phones), which take the 950 mAh cell. The
    3D view, parts list and cart, wiring label, use notes, fit check and
    OpenSCAD commands follow the phone's length.
    - Drop the USB radio link; the firmware, test and use text is Bluetooth only.
    - Fix the solar panel missing from the 3D view on the default version
    (the viewer only drew it for the old 950 mAh version).
    - Add doctype, charset and viewport so the page renders the same offline
    and on phones.
    -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
    [parts_list.csv]
2026-10-26 Close the plug channel at the front of the case
    The USB-C plug board channel was cut straight through to the front face,
    leaving a rectangular notch in the chin beside the screen with the board
    visible in it. It is now a closed 3.5 mm slot, open only to the phone
    pocket: the board slides in from the pocket and the front stays solid.
    - cad: channel is a slot (z only as tall as the board) instead of running
    up to the front face. The wire drop moves under the board's rear end,
    where its pads are, so the leads are soldered from the open back after
    the board is in.
    - Regenerate the body and fit-test STLs for all 9 phones, both versions,
    and the 3D viewer meshes in manual/phone-data.js. B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
    [a15_phone_body.stl, a15_phone_fit_test.stl, a15_solar_body.stl, a15_solar_fit_test.stl, a16_phone_body.stl, a16_phone_fit_test.stl, a16_solar_body.stl, a16_solar_fit_test.stl]
2026-10-26 Solar + battery: drop the mode switch
    The boost now always runs and the phone always charges from the case
    battery, so the phone's own charge control decides how much it takes.
    There is nothing to set.
    - cad: the battery version has no switch slot, dish or seat. The phone-only
    version keeps its switch.
    - manual: no switch in the 3D view, steps, wiring diagram or table (one
    56 kΩ resistor from phone CC1 to the shared 5 V line; boost EN left
    open) or use notes. The slide switch and the 5.1 kΩ resistor leave the
    Solar + battery parts list.
    - Regenerate the solar body and fit-test STLs and the 3D viewer meshes.
    - README and parts_list.csv follow.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
    [a15_solar_body.stl, a15_solar_fit_test.stl, a16_solar_body.stl, a16_solar_fit_test.stl, g25_solar_body.stl, g25_solar_fit_test.stl, gplay26_solar_body.stl, gplay26_solar_fit_test.stl]
2026-10-26 Put nearly every part in the one DigiKey cart
    Add the parts DigiKey sells that were bought elsewhere, using part numbers
    confirmed on DigiKey's product pages: slide switch 401-2001-ND, thermal
    cut-out 118-AD55ABB-ND, Adafruit silicone wire 1528-6181-ND and
    1528-3890-ND, and 3M VHB GPH-160GF foam tape 1067-GPH160GF-0.5-5-ND. The
    radio kit's number is now confirmed too. 26 of 29 lines are in the cart;
    the M2 screws, epoxy and ASA filament stay separate, with the reason
    noted on each.
    The foam tape is a change: 3M 4016 costs about $50 or more a roll at
    DigiKey, so the cart uses VHB (permanent bond, about $30). This adds about
    $22 per build; the part's note says it can be bought elsewhere inste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
    [parts_list.csv]
2026-10-26 Foam tape back to a separate, cheaper roll
    DigiKey's 3M VHB tape (about $30, permanent bond) and 3M 4016 (about $50 or
    more) cost far more than the roll bought elsewhere (about $10). The foam
    tape is marked as bought separately again; the note says why. The cart now
    holds 25 of 29 lines.
    [parts_list.csv]
2026-10-26 Manual: add a "How the phone charges" section
    A power-flow diagram and short notes at the top of the page, for each
    version, showing what feeds the shared 5 V line and how the phone ends up
    on the charging side (the 56 kΩ resistor on CC1 for Solar + battery; the
    mode switch for No solar). Adds a Charging link to the nav.
